DluhyFilip/web-controlled-psu/.gitignore.md

# KiCad ignorovane soubory a slozky
*-backups/
fp-info-cache
*.kicad_prl
