DluhyFilip/web-controlled-psu/docs/block-diagram.jpg

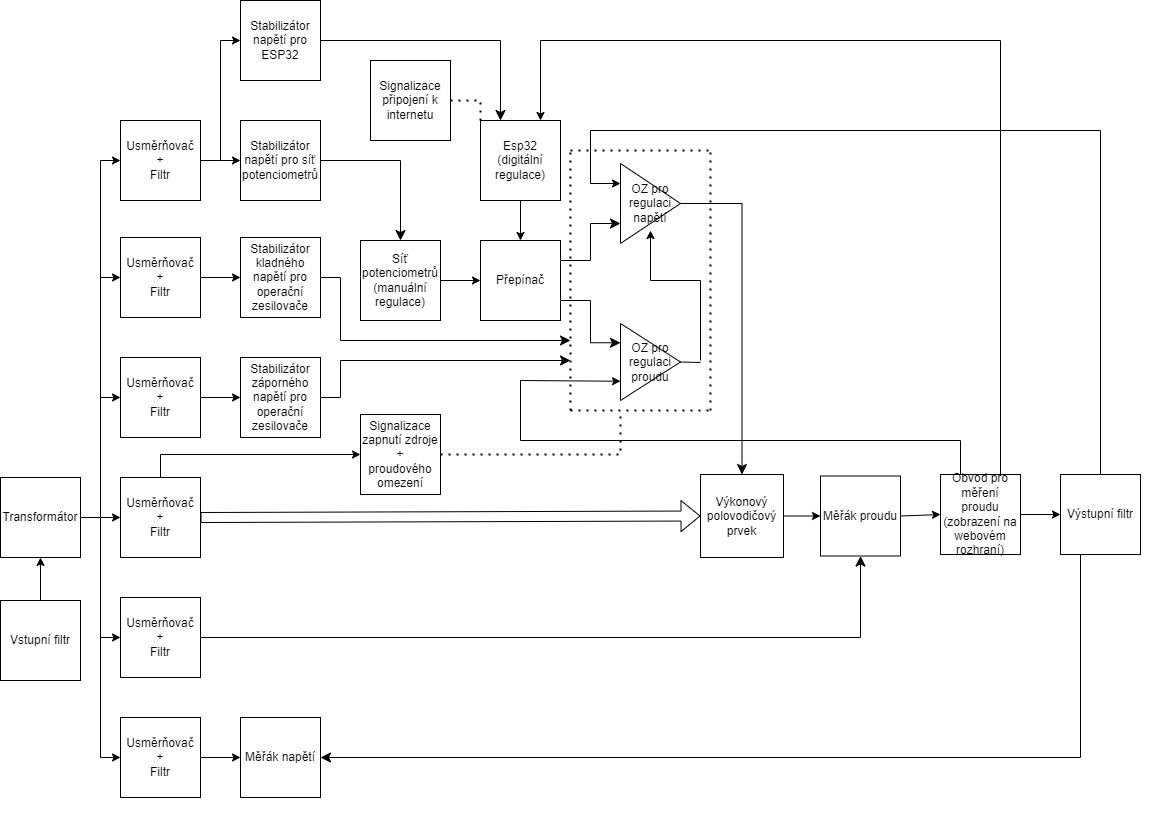
docs/block-diagram.jpg
