DluhyFilip/web-controlled-psu/hardware/PowerSupplyPart/final.kicad_pcb

## KiCad design hardware/PowerSupplyPart/final.kicad_pcb (2026-03-10)

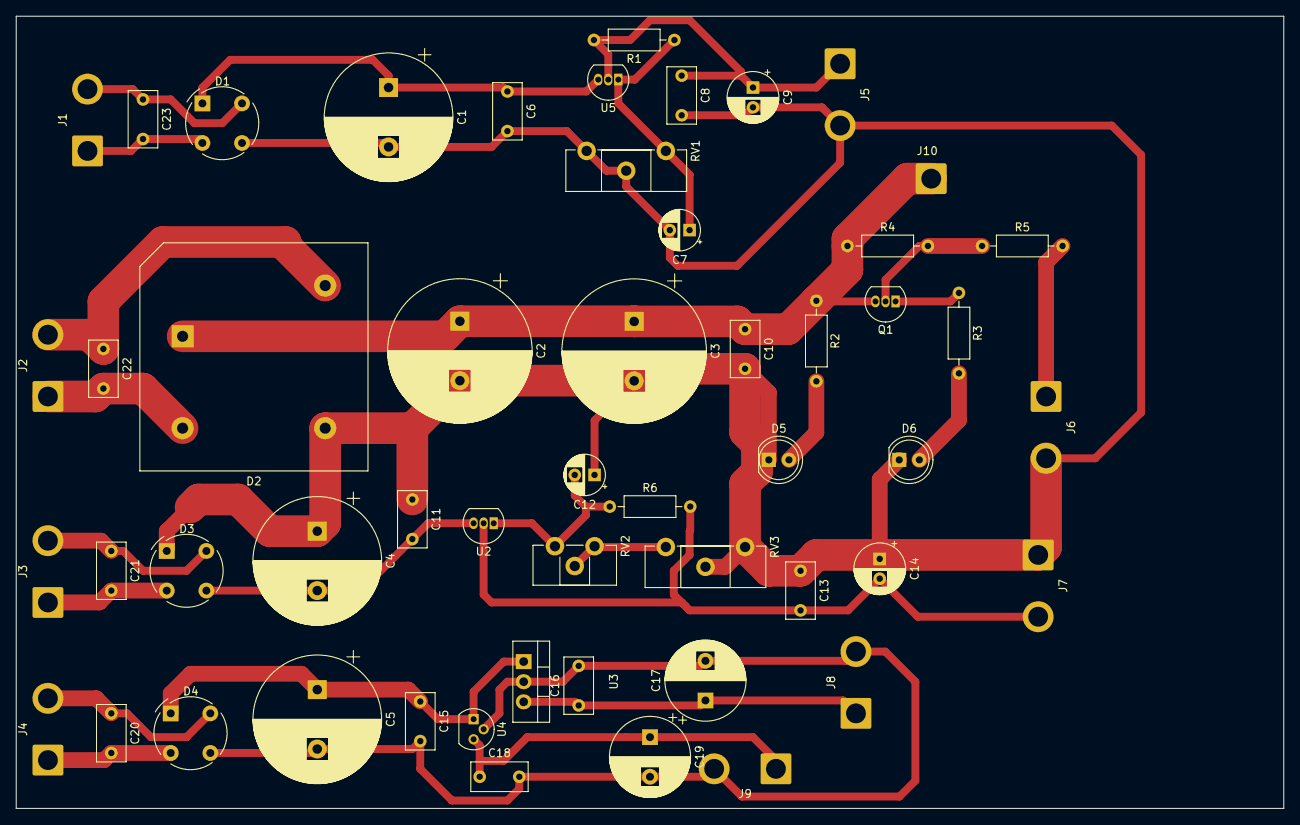
[picture p22: board final.kicad_pcb from above]

Board: 2 copper layers, 160.0 x 100.0 mm, 53 parts (0 on the bottom side), 26 nets.

Parts:
C1, C4, C5: C_Polarized; CP_Radial_D16.0mm_P7.50mm
C2, C3: C_Polarized; CP_Radial_D18.0mm_P7.50mm
C6, C8, C10, C11, C13, C15, C16, C18, C20, C21, C22, C23: C; C_Rect_L7.0mm_W3.5mm_P5.00mm
C7: C; CP_Radial_D5.0mm_P2.50mm
C9, C14: C_Polarized; CP_Radial_D6.3mm_P2.50mm
C12: C_Polarized; CP_Radial_D5.0mm_P2.50mm
C17, C19: C_Polarized; CP_Radial_D10.0mm_P5.00mm
D1, D3, D4: D_Bridge_+A-A; Diode_Bridge_Round_D9.0mm
D2: D_Bridge_+A-A; Diode_Bridge_28.6x28.6x7.3mm_P18.0mm_P11.6mm
D5, D6: LED; LED_D5.0mm
J1, J2, J3, J4, J5, J6, J7, J8, J9: Conn_01x02_Socket; SolderWire-2sqmm_1x02_P7.8mm_D2mm_OD3.9mm
J10: Conn_01x01_Socket; SolderWire-2sqmm_1x01_D2mm_OD3.9mm
Q1: BC556; TO-92_Inline
R1, R2, R3, R4, R5, R6: R; R_Axial_DIN0207_L6.3mm_D2.5mm_P10.16mm_Horizontal
RV1, RV3: R_Potentiometer; Potentiometer_Piher_PT-15-H01_Horizontal
RV2: R_Potentiometer; Potentiometer_Piher_PT-10-H01_Horizontal
U2: LM337L_TO92; TO-92_Inline
U3: LM78M05_TO220; TO-220-3_Vertical
U4: L7805; TO-92
U5: LM317L_TO92; TO-92_Inline

Connections:
unnamed: C1.1, C6.1, D1.1 (+), U5.3 (VI)
unnamed: C1.2, C2.2, C3.2, C4.1, C6.2, C7.2, C8.2, C9.2, C10.2, C11.1, C12.1, C13.1, C14.1, D1.3 (-), D2.3 (-), D3.1 (+), D5.1 (K), D6.1 (K), J5.2, J6.2, J7.1, RV1.2, RV1.3, RV3.1, RV3.2
unnamed: C2.1, C3.1, C10.1, D2.1 (+), J10.1, Q1.3 (E), R2.1, R4.1
unnamed: C4.2, C11.2, D3.3 (-), U2.3 (VI)
unnamed: C5.1, C15.1, D4.1 (+), U3.1 (VI), U4.1 (IN)
unnamed: C5.2, C15.2, C16.2, C17.2, C18.2, C19.2, D4.3 (-), J8.2, J9.2, U3.2 (GND), U4.2 (GND)
unnamed: D5.2 (A), R2.2
unnamed: D6.2 (A), R3.2
unnamed: C23.2, D1.2, J1.1
unnamed: C23.1, D1.4, J1.2
unnamed: C22.2, D2.2, J2.1
unnamed: C22.1, D2.4, J2.2
unnamed: C21.2, D3.2, J3.1
unnamed: C21.1, D3.4, J3.2
unnamed: C20.2, D4.2, J4.1
unnamed: C20.1, D4.4, J4.2
unnamed: C8.1, C9.1, J5.1, R1.2, U5.2 (VO)
unnamed: J6.1, R5.2
unnamed: C13.2, C14.2, J7.2, R6.2, U2.2 (VO)
unnamed: C16.1, C17.1, J8.1, U3.3 (VO)
unnamed: C18.1, C19.1, J9.1, U4.3 (OUT)
unnamed: Q1.2 (B), R4.2, R5.1
unnamed: Q1.1 (C), R3.1
unnamed: RV2.1, RV2.2, RV3.3
unnamed: C12.2, R6.1, RV2.3, U2.1 (ADJ)
unnamed: C7.1, R1.1, RV1.1, U5.1 (ADJ)
