DluhyFilip/web-controlled-psu/hardware/ControllerPart/ridici cast.kicad_pcb

## KiCad design hardware/ControllerPart/ridici cast.kicad_pcb (2026-03-10)

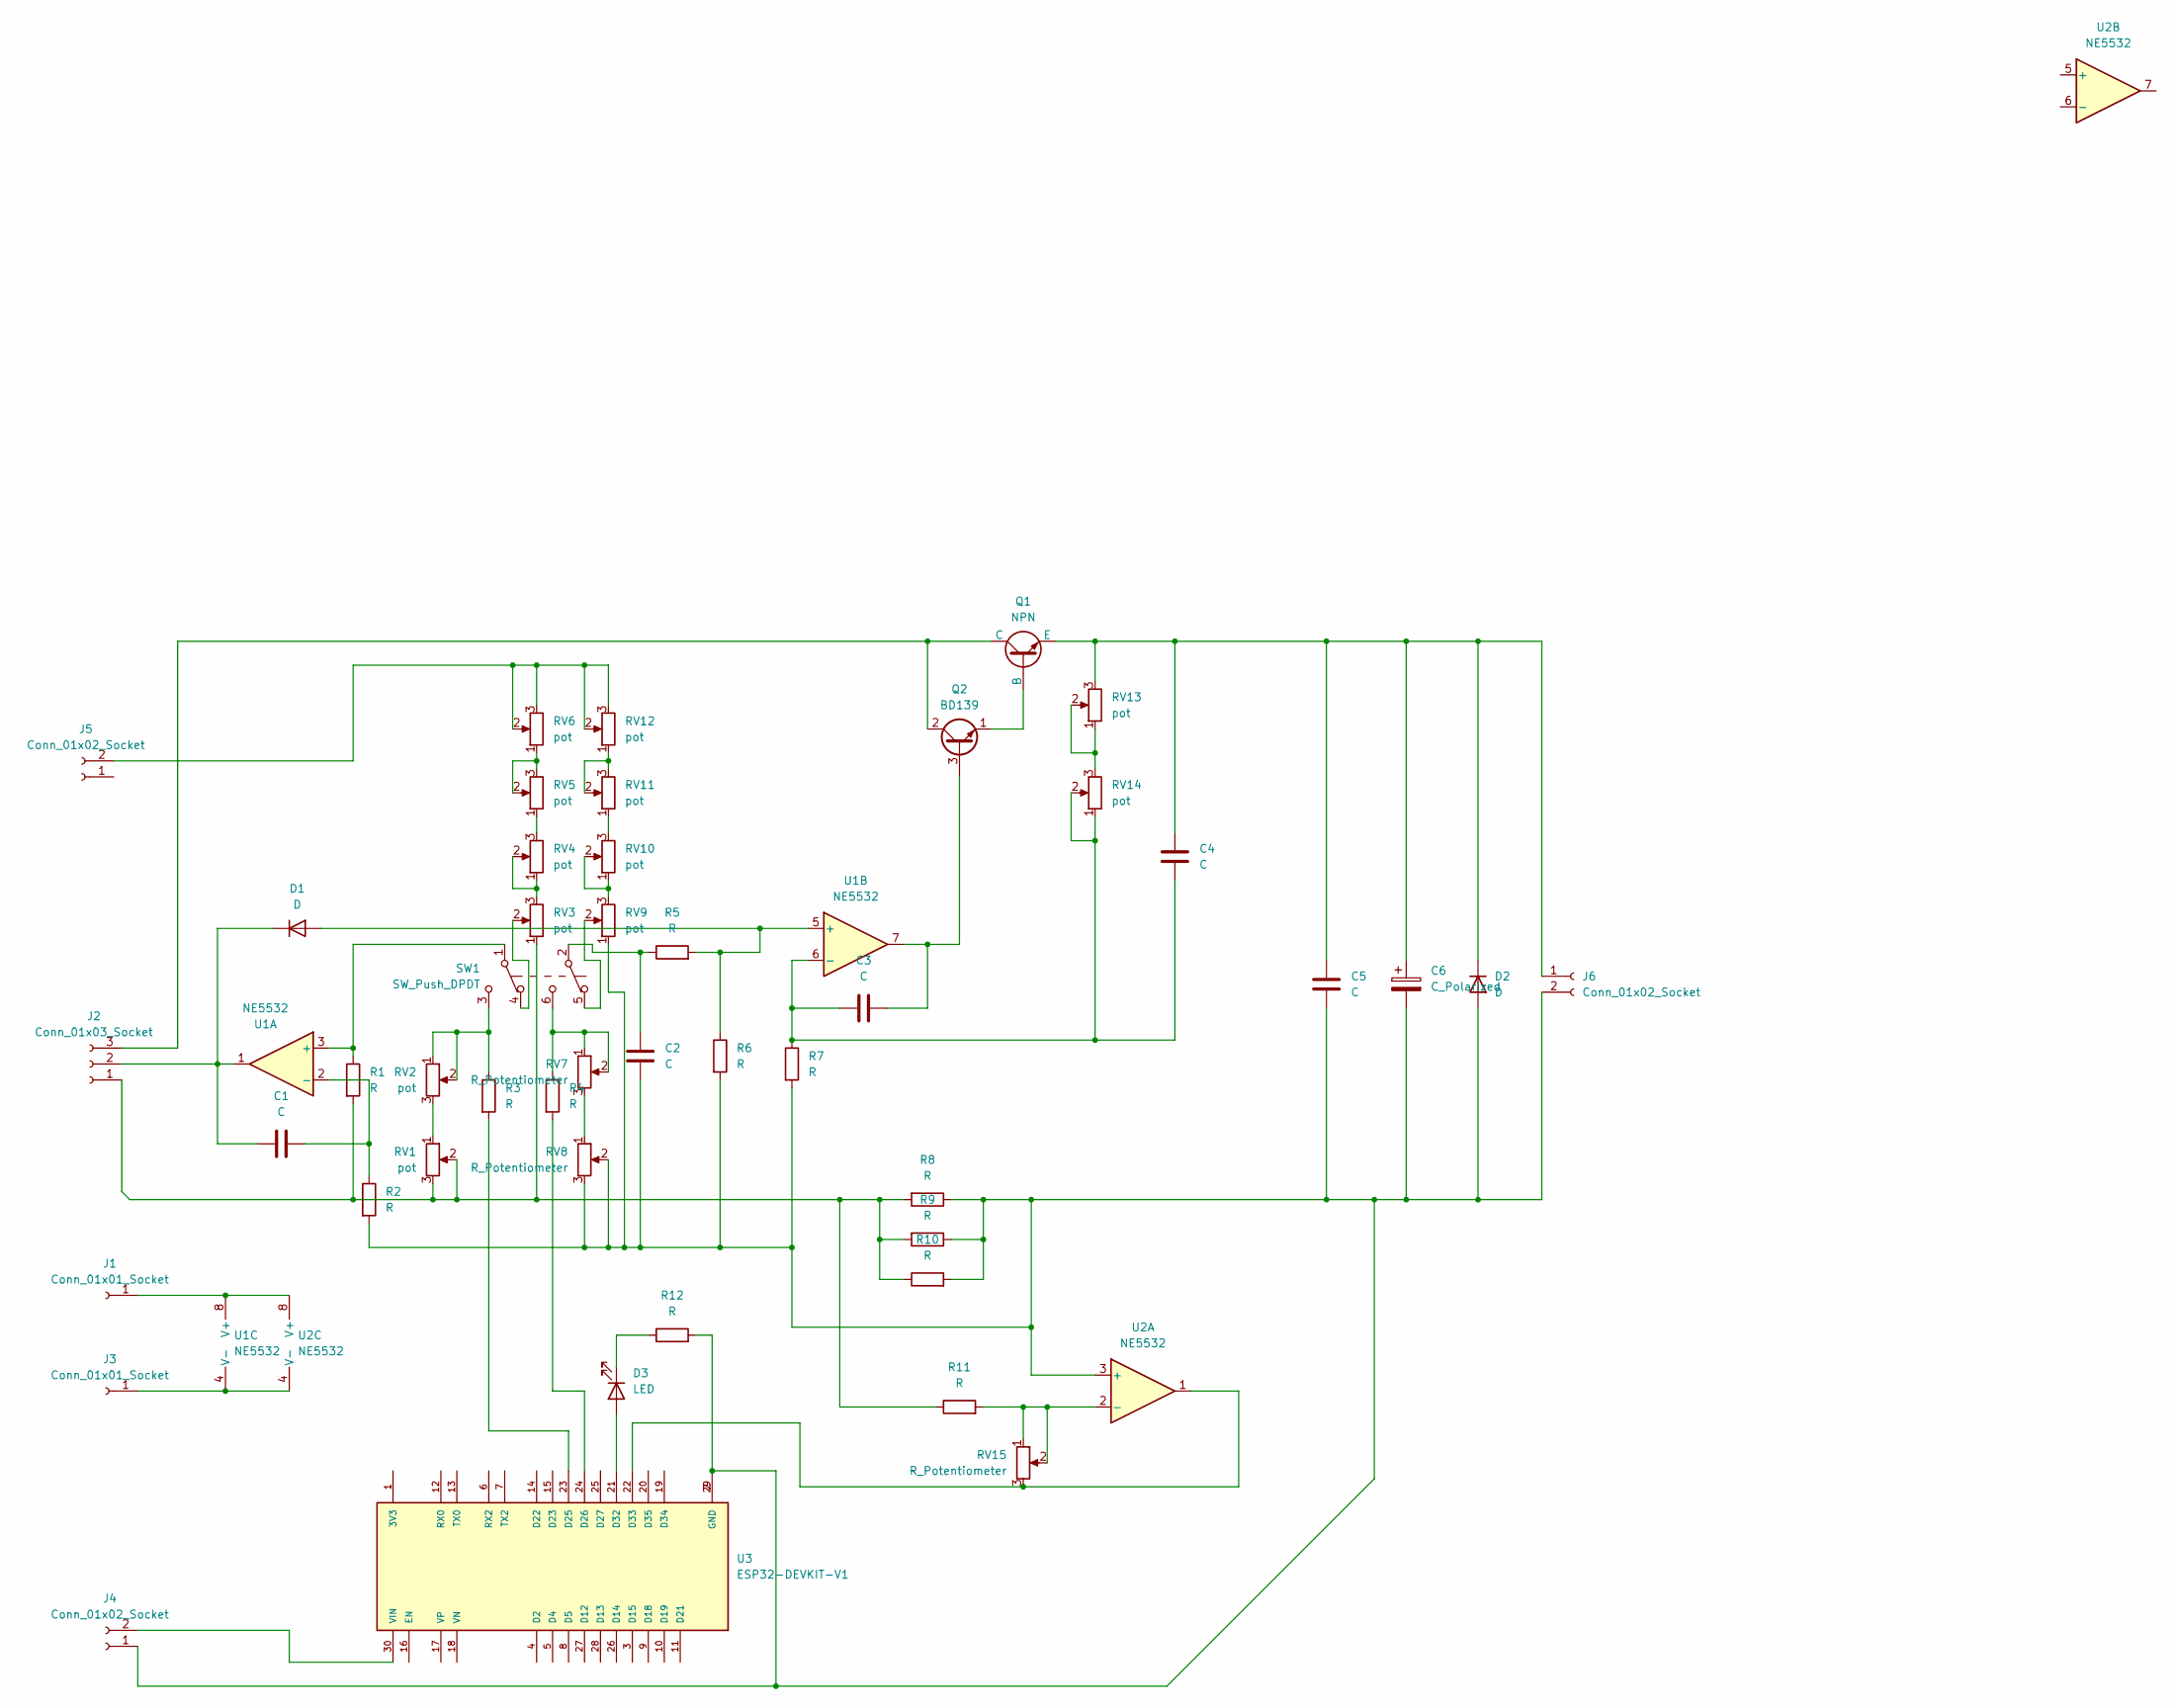
[picture p23: schematic ridici cast.kicad_sch]

Parts:
C1, C2, C3, C4, C5: C; C_Disc_D5.0mm_W2.5mm_P5.00mm
C6: C_Polarized; CP_Radial_D8.0mm_P2.50mm
D1, D2: D; D_DO-15_P12.70mm_Horizontal
D3: LED; LED_D5.0mm
J1, J3: Conn_01x01_Socket; SolderWire-2sqmm_1x01_D2mm_OD3.9mm
J2: Conn_01x03_Socket; SolderWire-2sqmm_1x03_P7.8mm_D2mm_OD3.9mm
J4, J5, J6: Conn_01x02_Socket; SolderWire-2sqmm_1x02_P7.8mm_D2mm_OD3.9mm
Q1: NPN; SolderWire-2sqmm_1x03_P7.8mm_D2mm_OD3.9mm
Q2: BD139; TO-126-3_Vertical
R1, R2, R3, R4, R5, R6, R7, R11, R12: R; R_Axial_DIN0204_L3.6mm_D1.6mm_P7.62mm_Horizontal
R8, R9, R10: R; R_Axial_Power_L48.0mm_W12.5mm_P55.88mm
RV1, RV2, RV6, RV11, RV12, RV14: pot; Potentiometer_Piher_PT-10-H01_Horizontal
RV3, RV4, RV9, RV10: pot; SolderWire-2sqmm_1x03_P7.8mm_D2mm_OD3.9mm
RV5, RV13: pot; Potentiometer_Piher_PT-15-H01_Horizontal
RV7, RV15: R_Potentiometer; Potentiometer_Piher_PT-10-H01_Horizontal
RV8: R_Potentiometer; Potentiometer_Piher_PT-15-H01_Horizontal
SW1: SW_Push_DPDT; SolderWire-2sqmm_1x06_P7.8mm_D2mm_OD3.9mm
U1, U2: NE5532; DIP-8_W7.62mm
U3: ESP32-DEVKIT-V1; MODULE_ESP32_DEVKIT_V1; PARTREV N/A

Connections:
unnamed: C2.1, R5.1, SW1.2 (B)
unnamed: D1.2 (A), R5.2, R6.1, U1.5 (+)
unnamed: C1.1, D1.1 (K), J2.2, U1.1
unnamed: C2.2, C5.2, C6.2, D2.2 (A), J4.1, J6.2, R2.2, R6.2, R7.2, R8.1, R9.1, R10.2, R12.2, RV8.2, RV8.3, RV9.1, U2.3 (+), U3.2 (GND), U3.29 (GND)
unnamed: C4.1, C5.1, C6.1, D2.1 (K), J6.1, Q1.3 (E), RV13.3
unnamed: D3.1 (K), R12.1
unnamed: J1.1, U1.8 (V+), U2.8 (V+)
unnamed: J2.1, R1.2, R8.2, R9.2, R10.1, R11.1, RV1.2, RV1.3, RV3.1
unnamed: J2.3, Q1.1 (C), Q2.2 (C)
unnamed: J3.1, U1.4 (V-), U2.4 (V-)
unnamed: J5.2, RV6.2, RV6.3, RV12.2, RV12.3
unnamed: Q1.2 (B), Q2.1 (E)
unnamed: C3.2, Q2.3 (B), U1.7
unnamed: R3.1, RV2.1, RV2.2, SW1.3 (C)
unnamed: R4.1, RV7.1, RV7.2, SW1.6 (C)
unnamed: RV1.1, RV2.3
unnamed: RV3.2, SW1.4 (A)
unnamed: RV3.3, RV4.1, RV4.2
unnamed: RV4.3, RV5.1
unnamed: RV5.2, RV5.3, RV6.1
unnamed: RV7.3, RV8.1
unnamed: RV9.2, SW1.5 (A)
unnamed: RV9.3, RV10.1, RV10.2
unnamed: RV10.3, RV11.1
unnamed: RV11.2, RV11.3, RV12.1
unnamed: RV13.1, RV13.2, RV14.3
unnamed: R1.1, SW1.1 (B), U1.3 (+)
unnamed: C1.2, R2.1, U1.2 (-)
unnamed: C3.1, C4.2, R7.1, RV14.1, RV14.2, U1.6 (-)
unnamed: R11.2, RV15.1, RV15.2, U2.2 (-)
unnamed: D3.2 (A), U3.21 (D32)
unnamed: RV15.3, U2.1, U3.22 (D33)
unnamed: R3.2, U3.23 (D25)
unnamed: R4.2, U3.24 (D26)
unnamed: J4.2, U3.30 (VIN)

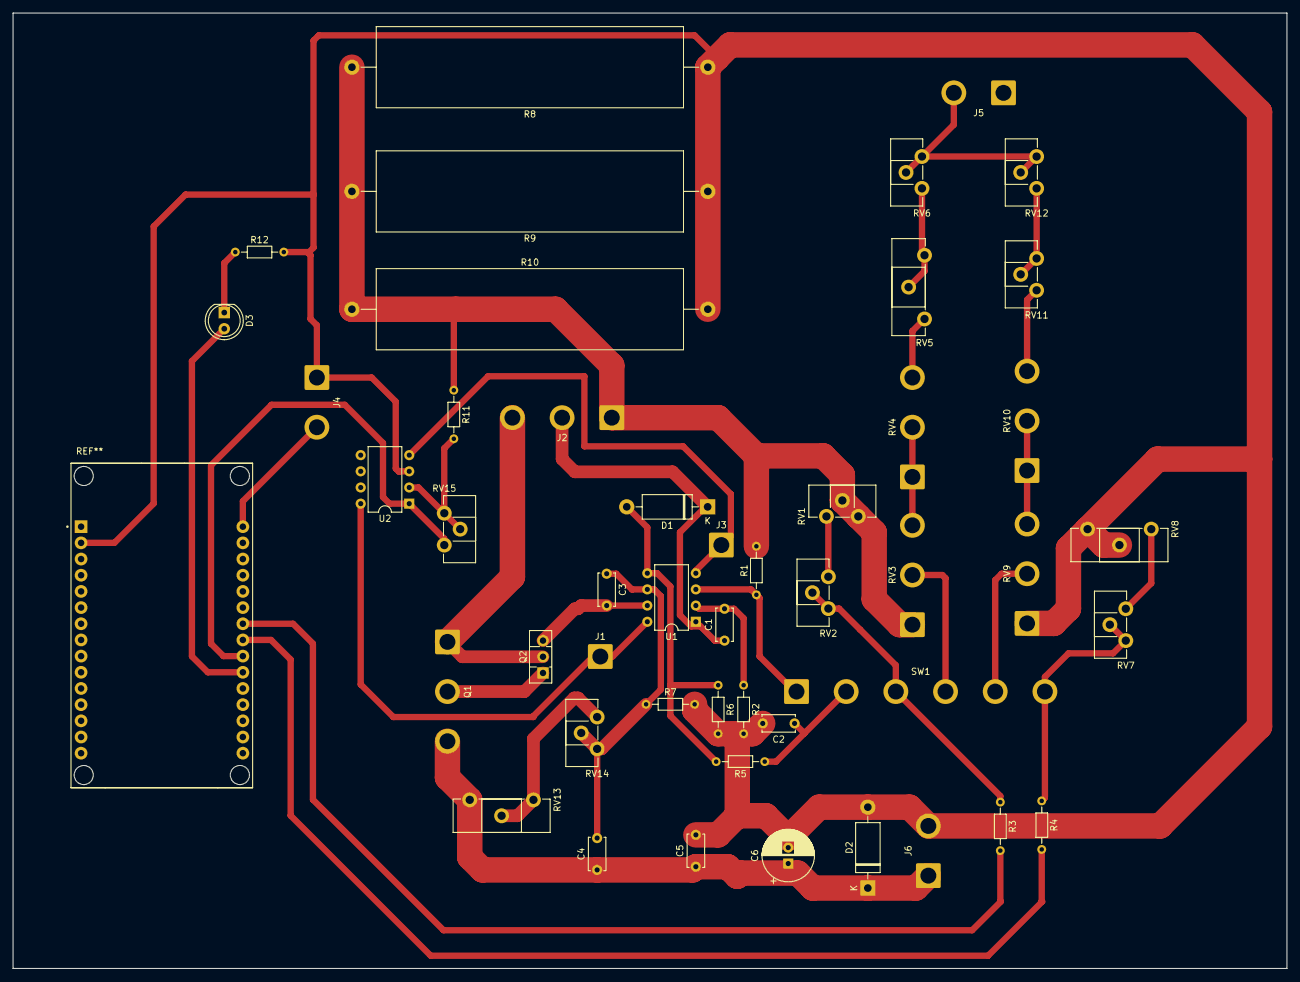
[picture p24: board ridici cast.kicad_pcb from above]

Board: 2 copper layers, 200.0 x 150.0 mm, 47 parts (0 on the bottom side), 30 nets.
